jmgrosen/magic-wand-usbc/README

the proprietary charger for the rechargeable magic wand is pretty annoying, isn't it? this is a dongle that lets you charge it with any 15W USB-C charger instead!
