jmgrosen/magic-wand-usbc/case.3mf

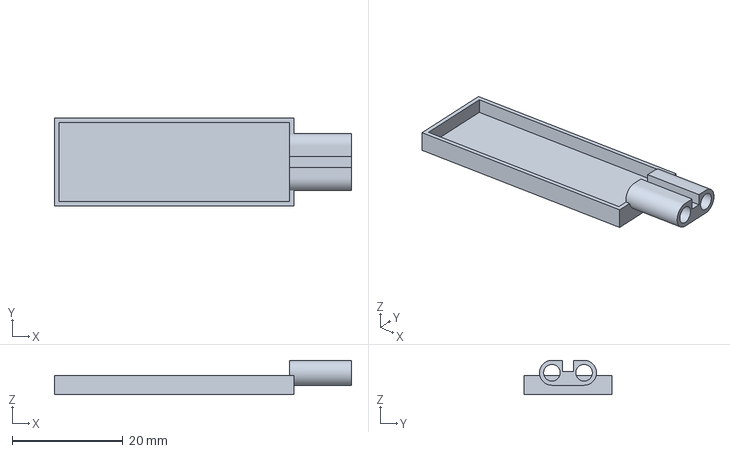
[picture p1: CAD file, 2025-06-07]
case.3mf
53.6 x 15.8 x 6.20 mm
