jmgrosen/magic-wand-usbc/magic-wand-usbc.kicad_pcb

## KiCad design magic-wand-usbc.kicad_pcb (2025-07-09)

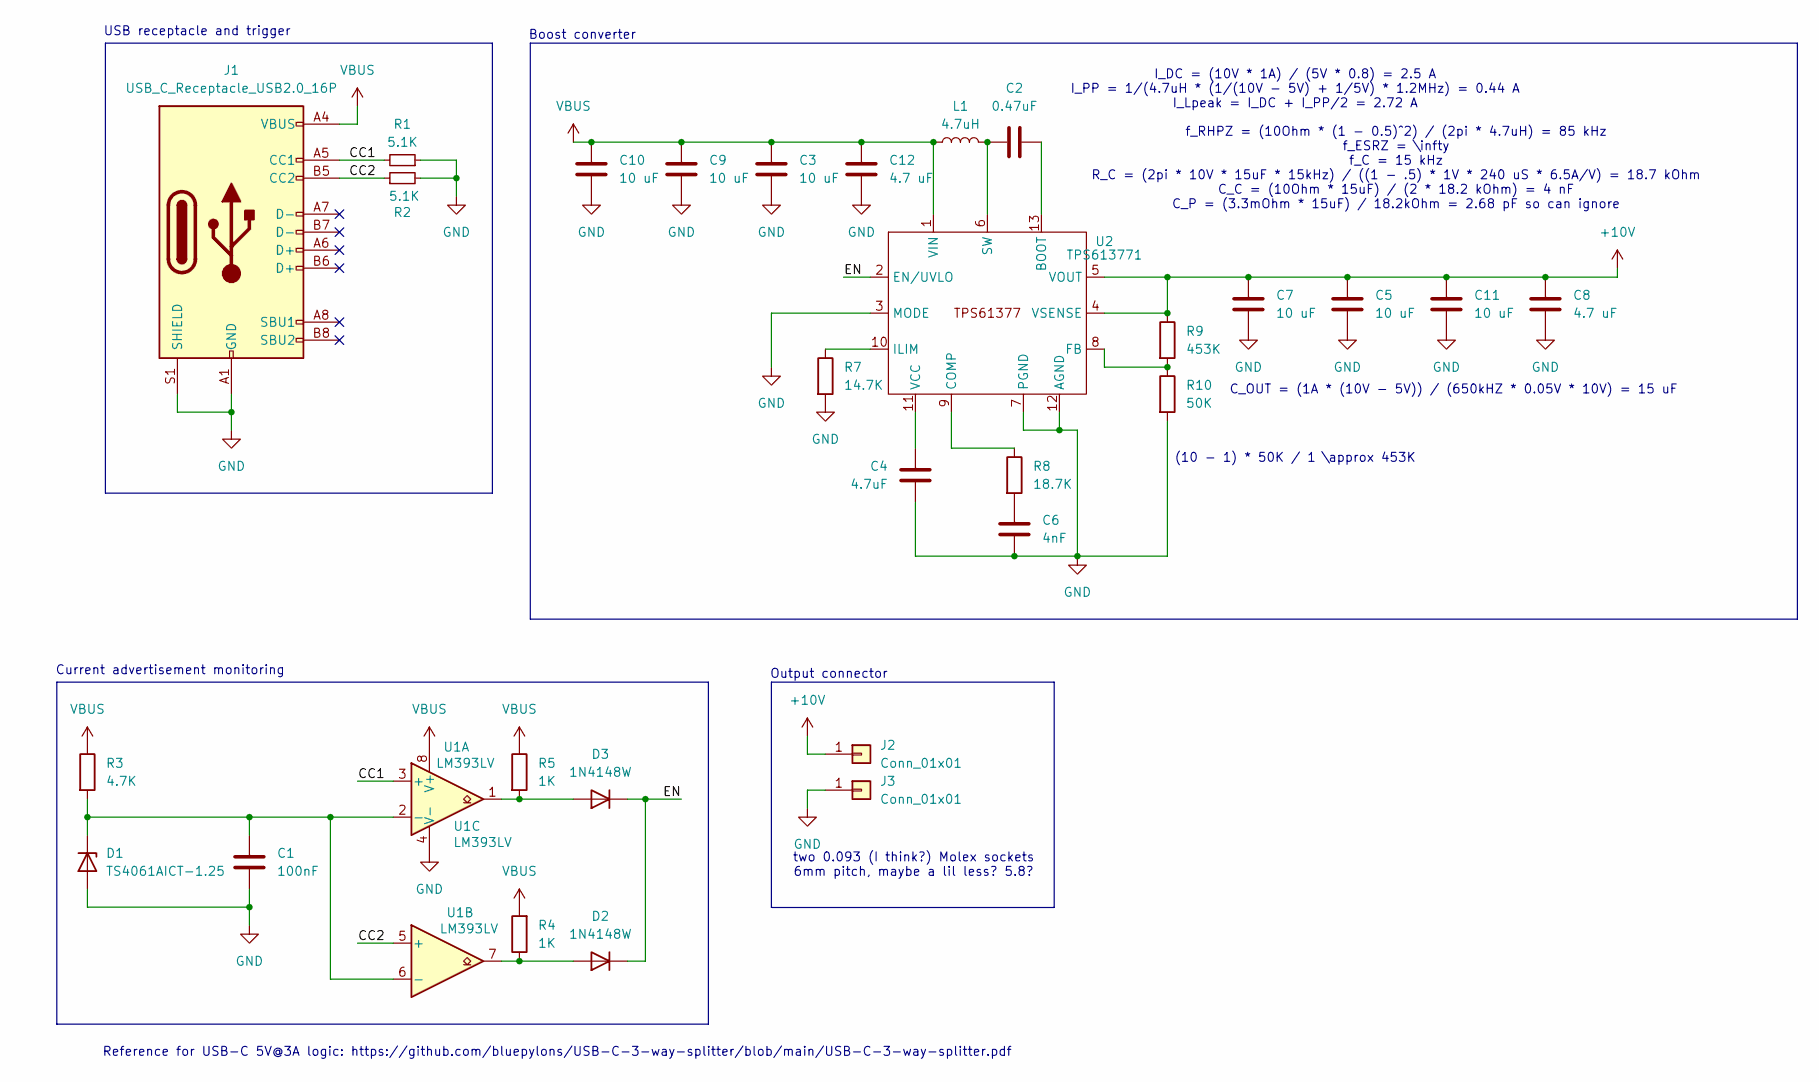
[picture p2: schematic magic-wand-usbc.kicad_sch, USB-C 5V@3A to Magic Wand 10V@1A Boost Converter]

Parts:
C1: 100nF; C_0402_1005Metric; DigiKey Part Number 1276-1043-1-ND
C2: 0.47uF; C_0402_1005Metric; DigiKey Part Number 311-1735-1-ND
C3, C5, C7, C9, C10, C11: 10 uF; C_0805_2012Metric; DigiKey Part Number 490-10514-1-ND
C4: 4.7uF; C_0402_1005Metric; DigiKey Part Number 490-GRM155C61E475ME15DCT-ND
C6: 4nF; C_0402_1005Metric; DigiKey Part Number 490-GCM155R71H392KA37DCT-ND
C8, C12: 4.7 uF; C_0402_1005Metric; DigiKey Part Number 490-GRM155C61E475ME15DCT-ND
D1: TS4061AICT-1.25; SOT-323_SC-70; DigiKey Part Number 497-15220-1-ND
D2, D3: 1N4148W; D_SOD-523; DigiKey Part Number 1N4148WTDICT-ND
J1: USB_C_Receptacle_USB2.0_16P; USB_C_Receptacle_GCT_USB4105-xx-A_16P_TopMnt_Horizontal; DigiKey Part Number 2073-USB4105-GF-ACT-ND
J2, J3: Conn_01x01; Molex_Socket_Janky
L1: 4.7uH; IND_SRP4030FA_BRN; Part Number SRP4030FA-4R7M; DigiKey Part Number SRP4030FA-4R7MCT-ND
R1, R2: 5.1K; R_0402_1005Metric; DigiKey Part Number 13-RC0402FR-135K1LCT-ND
R3: 4.7K; R_0402_1005Metric; DigiKey Part Number 311-4.7KLRCT-ND
R4, R5: 1K; R_0402_1005Metric; DigiKey Part Number 311-1.00KLRCT-ND
R7: 14.7K; R_0402_1005Metric; DigiKey Part Number YAG5262CT-ND
R8: 18.7K; R_0402_1005Metric; DigiKey Part Number YAG3018CT-ND
R9: 453K; R_0402_1005Metric; DigiKey Part Number YAG3164CT-ND
R10: 50K; R_0402_1005Metric; DigiKey Part Number 541-CRCW040250K0FKEDCT-ND
U1: LM393LV; WSON8_DSG_TEX; Part Number LM393LVDSGR; DigiKey Part Number 296-LM393LVDSGRCT-ND
U2: TPS613771; TPS61377-VQFN-HR13; DigiKey Part Number 296-TPS613771RYHRCT-ND

Connections:
+10V: C5.1, C7.1, C8.1, C11.1, J2.1, R9.1, U2.4 (VSENSE), U2.5 (VOUT)
/CC1: J1.A5 (CC1), R1.2, U1.3 (+)
/CC2: J1.B5 (CC2), R2.1, U1.5 (+)
/EN: D2.1 (K), D3.1 (K), U2.2 (EN/UVLO)
GND: C1.2, C3.2, C4.1, C5.2, C6.2, C7.2, C8.2, C9.2, C10.2, C11.2, C12.2, D1.2 (A), J1.A1 (GND), J1.A12 (GND), J1.B1 (GND), J1.B12 (GND), J1.S1 (SHIELD), J3.1, R1.1, R2.2, R7.2, R10.2, U1.4 (V-), U2.3 (MODE), U2.7 (PGND), U2.12 (AGND)
unnamed: C6.1, R8.2
unnamed: C1.1, D1.1 (K), R3.2, U1.2 (-), U1.6 (-)
unnamed: D2.2 (A), R4.1, U1.7
unnamed: D3.2 (A), R5.2, U1.1
unnamed: C2.2, U2.13 (BOOT)
unnamed: R8.1, U2.9 (COMP)
unnamed: R9.2, R10.1, U2.8 (FB)
unnamed: R7.1, U2.10 (ILIM)
unnamed: C2.1, L1.2, U2.6 (SW)
unnamed: C4.2, U2.11 (VCC)
VBUS: C3.1, C9.1, C10.1, C12.1, J1.A4 (VBUS), J1.A9 (VBUS), J1.B4 (VBUS), J1.B9 (VBUS), L1.1, R3.1, R4.2, R5.1, U1.8 (V+), U2.1 (VIN)

Notes on the sheet:
Reference for USB-C 5V@3A logic: https://github.com/bluepylons/USB-C-3-way-splitter/blob/main/USB-C-3-way-splitter.pdf
two 0.093 (I think?) Molex sockets 6mm pitch, maybe a lil less? 5.8?
(10 - 1) * 50K / 1 \approx 453K
f_RHPZ = (10Ohm * (1 - 0.5)^2) / (2pi * 4.7uH) = 85 kHz f_ESRZ = \infty f_C = 15 kHz R_C = (2pi * 10V * 15uF * 15kHz) / ((1 - .5) * 1V * 240 uS * 6.5A/V) = 18.7 kOhm C_C = (10Ohm * 15uF) / (2 * 18.2 kOhm) = 4 nF C_P = (3.3mOhm * 15uF) / 18.2kOhm = 2.68 pF so can ignore
Output connector
C_OUT = (1A * (10V - 5V)) / (650kHZ * 0.05V * 10V) = 15 uF
I_DC = (10V * 1A) / (5V * 0.8) = 2.5 A I_PP = 1/(4.7uH * (1/(10V - 5V) + 1/5V) * 1.2MHz) = 0.44 A I_Lpeak = I_DC + I_PP/2 = 2.72 A
Current advertisement monitoring
Boost converter
USB receptacle and trigger

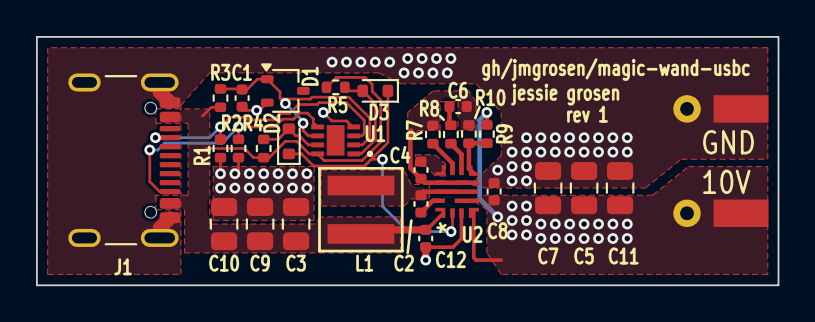
[picture p3: board magic-wand-usbc.kicad_pcb from above]

Board: 2 copper layers, 41.2 x 13.8 mm, 30 parts (0 on the bottom side), 16 nets.
