jmgrosen/magic-wand-usbc/(commit log)

2025-06-07 initial version
    [case.3mf, magic-wand-usbc.kicad_pcb, magic-wand-usbc.kicad_sch]
2025-07-09 update to kicad 9
    [magic-wand-usbc.kicad_pcb, magic-wand-usbc.kicad_sch]
